Dmartinz/Arduino-Weather-Station/README.md

# Arduino-Weather-Station
Materials intended to help others build their own weather station! Great for schools trying to encourage STEM!

The necessary libraries for the master code can be found in the intruction manual!
